SMDHuman/LOTPRobotdog2/README.md

# LOTP Robotdog V2
Opensource Modular Robot dog project. 
[About Project](https://youtu.be/w09KS9C38RI)
