SMDHuman/LOTPRobotdog2/Docs/Parça Listesi 20220502.pdf

06/03/2021

₺9,381.153 | Genel Toplam :
Malzeme | Ünite | Statü | Son Durum | Adet | Fiyat | Kargo | Toplam Maliyet | Alınan Site | Web Adresi
1 | | MPU 9250 9 Eksen Gyro İvme Manyetometre Sensör Modülü | | Satın alındı | Teslim alındı | 1 | 47.25 | 0 | 47.25 | Direnc.net | https://www.direnc.net/mpu-9250-9-eksen-gyro-hizlandirici-manyetometre-sensor-modulu
2 | | VL53L0X Time-of-Flight Regülatörlü Mesafe Sensörü - 200 cm - PL2490 | Lidar modülü | Satın alındı | Teslim alındı | 1 | 86.24 | 0 | 86.24 | Robotistan.com | https://www.robotistan.com/vl6180x-time-of-flight-mesafe-sensoru-1

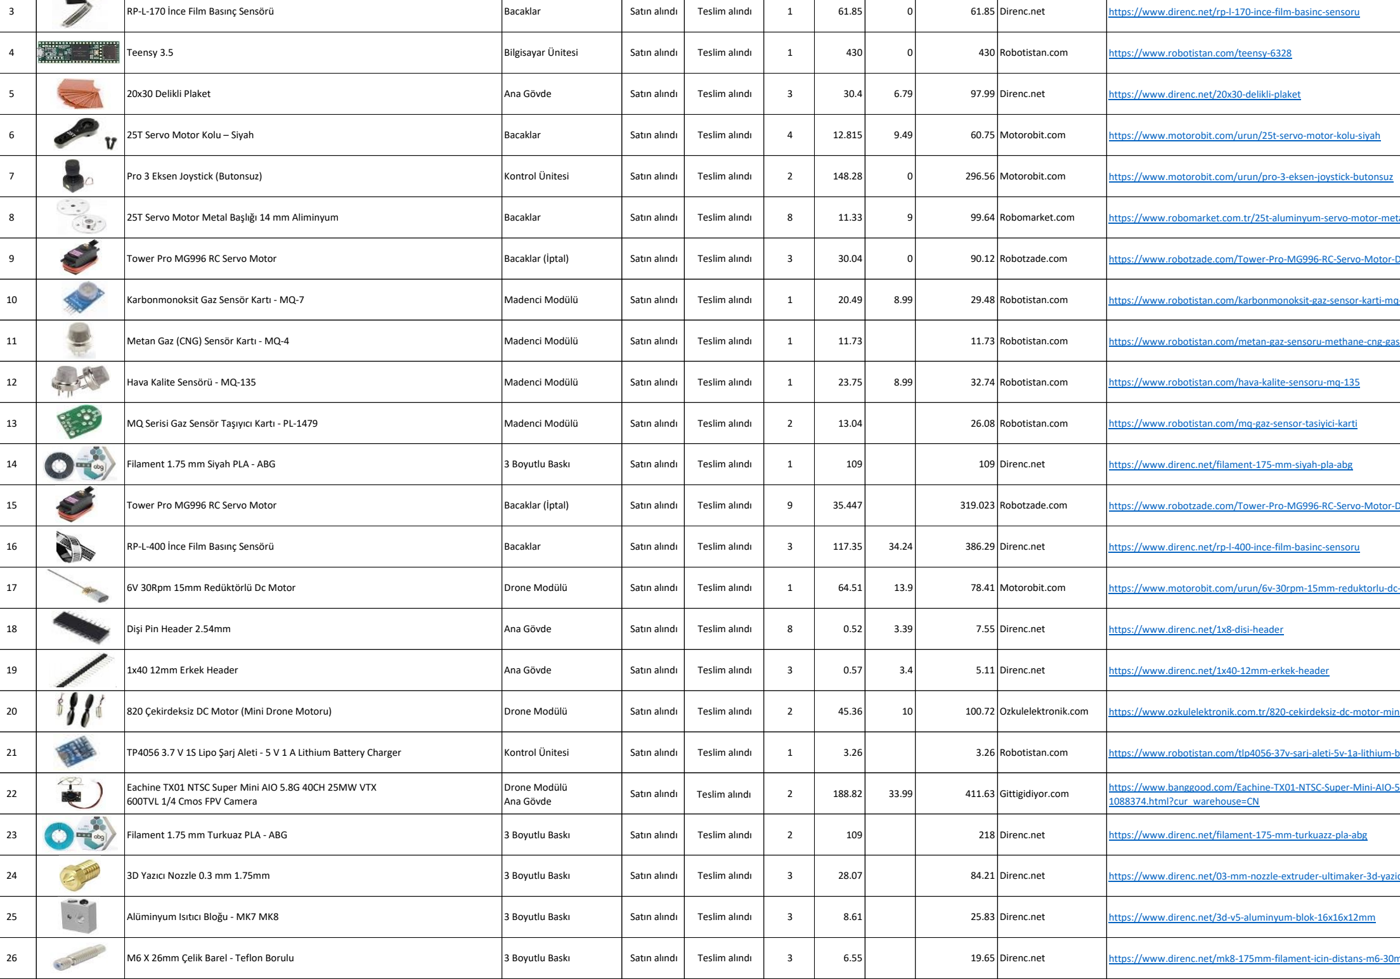
[picture p1: figure]
RP-L-170 İnce Film Basınç Sensörü; Bacaklar; Satın alındı; Teslim alındı; Direnc.net; https://www.direnc.net/rp-l-170-ince-film-basinc-sensoru; Teensy 3.5; Bilgisayar Ünitesi; Robotistan.com; https://www.robotistan.com/teensy-6328; 20x30 Delikli Plaket; Ana Gövde; https://www.direnc.net/20x30-delikli-plaket; Pro 3 Eksen Joystick (Butonsuz); Kontrol Ünitesi; Motorobit.com; https://www.motorobit.com/urun/pro-3-eksen-joystick-butonsuz; Hava Kalite Sensörü - MQ-135; Madenci Modülü; https://www.robotistan.com/hava-kalite-sensoru-mq-135; RP-L-400 İnce Film Basınç Sensörü; https://www.direnc.net/rp-l-400-ince-film-basinc-sensoru; Dişi Pin Header 2.54mm; https://www.direnc.net/1x8-disi-header; 1x40 12mm Erkek Header; https://www.direnc.net/1x40-12mm-erkek-header

6 | | 25T Servo Motor Kolu – Siyah | Bacaklar | Satın alındı | Teslim alındı | 4 | 12.815 | 9.49 | 60.75 | Motorobit.com | https://www.motorobit.com/urun/25t-servo-motor-kolu-siyah
8 | | 25T Servo Motor Metal Başlığı 14 mm Aliminyum | Bacaklar | Satın alındı | Teslim alındı | 8 | 11.33 | 9 | 99.64 | Robomarket.com | https://www.robomarket.com.tr/25t-aluminyum-servo-motor-metal-basligi
9 | | Tower Pro MG996 RC Servo Motor | Bacaklar (İptal) | Satın alındı | Teslim alındı | 3 | 30.04 | 0 | 90.12 | Robotzade.com | https://www.robotzade.com/Tower-Pro-MG996-RC-Servo-Motor-Dijital,PR-1145.html
10 | | Karbonmonoksit Gaz Sensör Kartı - MQ-7 | Madenci Modülü | Satın alındı | Teslim alındı | 1 | 20.49 | 8.99 | 29.48 | Robotistan.com | https://www.robotistan.com/karbonmonoksit-gaz-sensor-karti-mq-7
11 | | Metan Gaz (CNG) Sensör Kartı - MQ-4 | Madenci Modülü | Satın alındı | Teslim alındı | 1 | 11.73 | | 11.73 | Robotistan.com | https://www.robotistan.com/metan-gaz-sensoru-methane-cng-gas-sensor-mq-4
13 | | MQ Serisi Gaz Sensör Taşıyıcı Kartı - PL-1479 | Madenci Modülü | Satın alındı | Teslim alındı | 2 | 13.04 | | 26.08 | Robotistan.com | https://www.robotistan.com/mq-gaz-sensor-tasiyici-karti
14 | | Filament 1.75 mm Siyah PLA - ABG | 3 Boyutlu Baskı | Satın alındı | Teslim alındı | 1 | 109 | | 109 | Direnc.net | https://www.direnc.net/filament-175-mm-siyah-pla-abg
15 | | Tower Pro MG996 RC Servo Motor | Bacaklar (İptal) | Satın alındı | Teslim alındı | 9 | 35.447 | | 319.023 | Robotzade.com | https://www.robotzade.com/Tower-Pro-MG996-RC-Servo-Motor-Dijital,PR-1145.html
17 | | 6V 30Rpm 15mm Redüktörlü Dc Motor | Drone Modülü | Satın alındı | Teslim alındı | 1 | 64.51 | 13.9 | 78.41 | Motorobit.com | https://www.motorobit.com/urun/6v-30rpm-15mm-reduktorlu-dc-motor
20 | | 820 Çekirdeksiz DC Motor (Mini Drone Motoru) | Drone Modülü | Satın alındı | Teslim alındı | 2 | 45.36 | 10 | 100.72 | Ozkulelektronik.com | https://www.ozkulelektronik.com.tr/820-cekirdeksiz-dc-motor-mini-drone-motoru
21 | | TP4056 3.7 V 1S Lipo Şarj Aleti - 5 V 1 A Lithium Battery Charger | Kontrol Ünitesi | Satın alındı | Teslim alındı | 1 | 3.26 | | 3.26 | Robotistan.com | https://www.robotistan.com/tlp4056-37v-sarj-aleti-5v-1a-lithium-battery-charger
22 | | Eachine TX01 NTSC Super Mini AIO 5.8G 40CH 25MW VTX 600TVL 1/4 Cmos FPV Camera | Drone Modülü Ana Gövde | Satın alındı | Teslim alındı | 2 | 188.82 | 33.99 | 411.63 | Gittigidiyor.com | https://www.banggood.com/Eachine-TX01-NTSC-Super-Mini-AIO-5_8G-40CH-25MW-VTX-600TVL-1-or-4-Cmos-FPV-Camera-p-1088374.html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 (https://www.banggood.com/Eachine-TX01-NTSC-Super-Mini-AIO-5_8G-40CH-25MW-VTX-600TVL-1-or-4-Cmos-FPV-Camera-p-1088374.html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)
23 | | Filament 1.75 mm Turkuaz PLA - ABG | 3 Boyutlu Baskı | Satın alındı | Teslim alındı | 2 | 109 | | 218 | Direnc.net | https://www.direnc.net/filament-175-mm-turkuazz-pla-abg
24 | | 3D Yazıcı Nozzle 0.3 mm 1.75mm | 3 Boyutlu Baskı | Satın alındı | Teslim alındı | 3 | 28.07 | | 84.21 | Direnc.net | https://www.direnc.net/03-mm-nozzle-extruder-ultimaker-3d-yazici
25 | | Alüminyum Isıtıcı Bloğu - MK7 MK8 | 3 Boyutlu Baskı | Satın alındı | Teslim alındı | 3 | 8.61 | | 25.83 | Direnc.net | https://www.direnc.net/3d-v5-aluminyum-blok-16x16x12mm
26 | | M6 X 26mm Çelik Barel - Teflon Borulu | 3 Boyutlu Baskı | Satın alındı | Teslim alındı | 3 | 6.55 | | 19.65 | Direnc.net | https://www.direnc.net/mk8-175mm-filament-icin-distans-m6-30mm

# PROJE MALZEME LİSTESİ

₺9,381.153

₺9,381.153

### Satın Alınan :

### Planlanan/İptal :

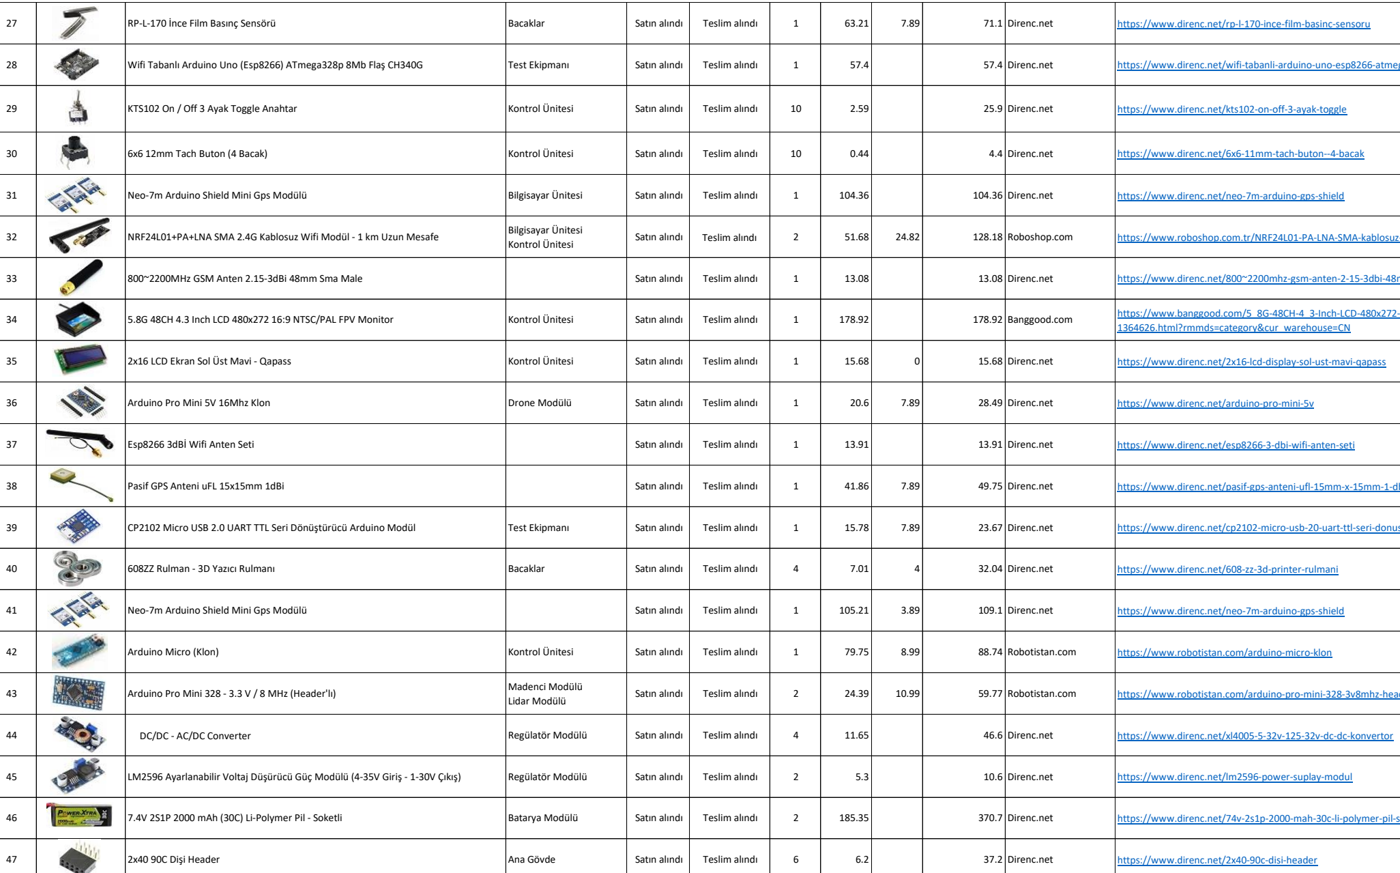
[picture p2: figure]
RP-L-170 İnce Film Basınç Sensörü; Bacaklar; Satın alındı; Teslim alındı; Direnc.net; https://www.direnc.net/rp-l-170-ince-film-basinc-sensoru; Esp8266 3dBİ Wifi Anten Seti; https://www.direnc.net/esp8266-3-dbi-wifi-anten-seti; Arduino Micro (Klon); Kontrol Ünitesi; Robotistan.com; https://www.robotistan.com/arduino-micro-klon; DC/DC - AC/DC Converter; Regülatör Modülü; https://www.direnc.net/xl4005-5-32v-125-32v-dc-dc-konvertor; 2x40 90C Dişi Header; Ana Gövde; https://www.direnc.net/2x40-90c-disi-header

28 | Wifi Tabanlı Arduino Uno (Esp8266) ATmega328p 8Mb Flaş CH340G | Test Ekipmanı | Satın alındı | Teslim alındı | 1 | 57.4 | | 57.4 | Direnc.net | https://www.direnc.net/wifi-tabanli-arduino-uno-esp8266-atmega328p-8mb-flas-ch340g
29 | KTS102 On / Off 3 Ayak Toggle Anahtar | Kontrol Ünitesi | Satın alındı | Teslim alındı | 10 | 2.59 | | 25.9 | Direnc.net | https://www.direnc.net/kts102-on-off-3-ayak-toggle
30 | 6x6 12mm Tach Buton (4 Bacak) | Kontrol Ünitesi | Satın alındı | Teslim alındı | 10 | 0.44 | | 4.4 | Direnc.net | https://www.direnc.net/6x6-11mm-tach-buton--4-bacak
31 | Neo-7m Arduino Shield Mini Gps Modülü | Bilgisayar Ünitesi | Satın alındı | Teslim alındı | 1 | 104.36 | | 104.36 | Direnc.net | https://www.direnc.net/neo-7m-arduino-gps-shield
32 | NRF24L01+PA+LNA SMA 2.4G Kablosuz Wifi Modül - 1 km Uzun Mesafe | Bilgisayar Ünitesi Kontrol Ünitesi | Satın alındı | Teslim alındı | 2 | 51.68 | 24.82 | 128.18 | Roboshop.com | https://www.roboshop.com.tr/NRF24L01-PA-LNA-SMA-kablosuz-wifi-modul-uzun-mesafe
33 | 800~2200MHz GSM Anten 2.15-3dBi 48mm Sma Male | | Satın alındı | Teslim alındı | 1 | 13.08 | | 13.08 | Direnc.net | https://www.direnc.net/800~2200mhz-gsm-anten-2-15-3dbi-48mm-sma-male
34 | 5.8G 48CH 4.3 Inch LCD 480x272 16:9 NTSC/PAL FPV Monitor | Kontrol Ünitesi | Satın alındı | Teslim alındı | 1 | 178.92 | | 178.92 | Banggood.com | https://www.banggood.com/5_8G-48CH-4_3-Inch-LCD-480x272-16-9-NTSC-or-PAL-FPV-Monitor-Auto-Search-With-OSD-Build-in-Battery-p-1364626.html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 (https://www.banggood.com/5_8G-48CH-4_3-Inch-LCD-480x272-16-9-NTSC-or-PAL-FPV-Monitor-Auto-Search-With-OSD-Build-in-Battery-p-1364626.html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)
35 | 2x16 LCD Ekran Sol Üst Mavi - Qapass | Kontrol Ünitesi | Satın alındı | Teslim alındı | 1 | 15.68 | 0 | 15.68 | Direnc.net | https://www.direnc.net/2x16-lcd-display-sol-ust-mavi-qapass
36 | Arduino Pro Mini 5V 16Mhz Klon | Drone Modülü | Satın alındı | Teslim alındı | 1 | 20.6 | 7.89 | 28.49 | Direnc.net | https://www.direnc.net/arduino-pro-mini-5v
38 | Pasif GPS Anteni uFL 15x15mm 1dBi | | Satın alındı | Teslim alındı | 1 | 41.86 | 7.89 | 49.75 | Direnc.net | https://www.direnc.net/pasif-gps-anteni-ufl-15mm-x-15mm-1-dbi-kazanc-adafruit
39 | CP2102 Micro USB 2.0 UART TTL Seri Dönüştürücü Arduino Modül | Test Ekipmanı | Satın alındı | Teslim alındı | 1 | 15.78 | 7.89 | 23.67 | Direnc.net | https://www.direnc.net/cp2102-micro-usb-20-uart-ttl-seri-donusturucu-arduino-modul
40 | 608ZZ Rulman - 3D Yazıcı Rulmanı | Bacaklar | Satın alındı | Teslim alındı | 4 | 7.01 | 4 | 32.04 | Direnc.net | https://www.direnc.net/608-zz-3d-printer-rulmani
41 | Neo-7m Arduino Shield Mini Gps Modülü | | Satın alındı | Teslim alındı | 1 | 105.21 | 3.89 | 109.1 | Direnc.net | https://www.direnc.net/neo-7m-arduino-gps-shield
43 | Arduino Pro Mini 328 - 3.3 V / 8 MHz (Header'lı) | Madenci Modülü Lidar Modülü | Satın alındı | Teslim alındı | 2 | 24.39 | 10.99 | 59.77 | Robotistan.com | https://www.robotistan.com/arduino-pro-mini-328-3v8mhz-headerli
45 | LM2596 Ayarlanabilir Voltaj Düşürücü Güç Modülü (4-35V Giriş - 1-30V Çıkış) | Regülatör Modülü | Satın alındı | Teslim alındı | 2 | 5.3 | | 10.6 | Direnc.net | https://www.direnc.net/lm2596-power-suplay-modul
46 | 7.4V 2S1P 2000 mAh (30C) Li-Polymer Pil - Soketli | Batarya Modülü | Satın alındı | Teslim alındı | 2 | 185.35 | | 370.7 | Direnc.net | https://www.direnc.net/74v-2s1p-2000-mah-30c-li-polymer-pil-soketli
48 | 1x40 90C Dişi Header | Ana Gövde | Satın alındı | Teslim alındı | 6 | 1.24 | | 7.44 | Direnc.net | https://www.direnc.net/1x40-90c-disi-header
49 | 1x40 32mm Erkek Header | Ana Gövde | Satın alındı | Teslim alındı | 15 | 3.36 | 7.89 | 58.29 | Direnc.net | https://www.direnc.net/1x40-32mm-erkek-header
50 | 2.5 V -30V Mini Dijital Kırmızı Voltmetre | Regülatör Modülü | Satın alındı | Teslim alındı | 2 | 15.47 | 7.89 | 38.83 | Direnc.net | https://www.direnc.net/25-v-30-v-mini-dijital-kirmizi-voltmetre
51 | TO126 Silikon İzolatör | | Satın alındı | Teslim alındı | 6 | 0.88 | | 5.28 | Direnc.net | https://www.direnc.net/to126-izalator
52 | XT60 Plug 60A Li-Po Konnektör Takım | Batarya Modülü | Satın alındı | Teslim alındı | 4 | 4.86 | | 19.44 | Direnc.net | https://www.direnc.net/xt60-plug-60a-li-po-konnektor
53 | 3.7V 590 mAh Li-Polymer Pil | Kontrol Ünitesi | Satın alındı | Teslim alındı | 1 | 46.79 | | 46.79 | Direnc.net | https://www.direnc.net/37v-590-mah-li-polymer-pil
54 | 5V Voltaj Yükseltici Regülatörü 0.5/5.5V Giriş | Kontrol Ünitesi | Satın alındı | Teslim alındı | 1 | 46.74 | 8.99 | 55.73 | Robotistan.com | https://www.robotistan.com/5v-yukseltecli-voltaj-regulatoru-ncp1402-5v-boost-regulator-ncp1402-pl
55 | Wireless NRF24L01 2.4 GHz Transceiver Modül - 2.4 GHz Alıcı Verici Modül | Drone Modülü | Satın alındı | Teslim alındı | 1 | 7.67 | 8.99 | 16.66 | Robotistan.com | https://www.robotistan.com/wireless-nrf24l01-24ghz-transceiver-modul-24ghz-alici-verici-modul-1

56 | MPU6050 6 Eksen İvme ve Gyro Sensörü - GY-521 | | Satın alındı | Teslim alındı | 1 | 10.29 | | 10.29 | Robotistan.com | https://www.robotistan.com/mpu6050-6-eksen-ivme-ve-gyro-sensoru-6-dof-3-axis-accelerometer-and-gyros?gclid
57 | Arduino Pro Mini 328 - 3.3 V / 8 MHz (Header'lı) | Madenci Modülü Lidar Modülü | Satın alındı | Teslim alındı | 2 | 24.32 | | 48.64 | Robotistan.com | https://www.robotistan.com/arduino-pro-mini-328-3v8mhz-headerli
58 | 3D Yazıcı Fanı 12V 40x40 mm | 3 Boyutlu Baskı | Satın alındı | Teslim alındı | 1 | 15.19 | 9.5 | 24.69 | Robotzade.com | https://www.robotzade.com/urun/3d-yazici-fani-12v-40x40-mm
59 | Seramik Kablolu 28dB Yüksek Kazançlı Aktif GPS Anteni | Bilgisayar Ünitesi | Satın alındı | Teslim alındı | 1 | 23.09 | 13.9 | 36.99 | Motorobit.com | https://www.motorobit.com/urun/seramik-kablolu-28db-yuksek-kazancli-aktif-gps-anteni
60 | Filament 1.75 mm Siyah PLA - ABG | 3 Boyutlu Baskı | Satın alındı | Teslim alındı | 1 | 133.02 | 9.9 | 142.92 | Direnc.net | https://www.direnc.net/filament-175-mm-siyah-pla-abg
61 | Alüminyum Isıtıcı Bloğu - MK7 MK8 | 3 Boyutlu Baskı | Satın alındı | Teslim alındı | 6 | 8.45 | 9.9 | 60.6 | Direnc.net | https://www.direnc.net/3d-v5-aluminyum-blok-16x16x12mm
62 | M6 X 26mm Çelik Barel - Teflon Borulu | 3 Boyutlu Baskı | Satın alındı | Teslim alındı | 6 | 5.52 | 8.45 | 41.57 | Robitshop.com | https://www.robitshop.com/urun/m6-x-26mm-celik-barel-teflon-borulu
63 | Yarıklı Ağırlık Takımı | Ana Gövde | Satın alındı | Teslim alındı | 2 | 49.98 | 12 | 111.96 | AromelKimya | https://www.aromelkimya.com/urun/yarikli-agirlik-takimi-1
64 | Tower Pro MG996 RC Servo Motor | Bacaklar (İptal) | Satın alındı | Teslim alındı | 3 | 30.58 | 12.5 | 104.24 | Robotzade.com | https://www.robotzade.com/Tower-Pro-MG996-RC-Servo-Motor-Dijital,PR-1145.html
65 | iMax B3 Compact Lipo (2-3S) Şarj Aleti | Batarya Şarj | Satın alındı | Teslim alındı | 1 | 51.41 | 8.45 | 59.86 | Robitshop.com | https://www.robitshop.com/urun/a3-compact-lipo-2-3s-sarj-aleti
66 | MG958 X-Large Digital Servo | Bacaklar | Satın alındı | Teslim alındı | 5 | 65 | 14 | 339 | Pilottr.com | https://www.pilottr.com/urun/towerpro-mg958-servo.html
67 | 5mm Bakır Bant 30mt | Lidar modülü | Satın alındı | Teslim alındı | 1 | 41.21 | | 41.21 | Direnc.net | https://www.direnc.net/5mm-termal-bant-30mt
68 | 7.4 V 2S Lipo Batarya 1350 mAh 25C | Yedek Batarya Modülü | Satın alındı | Teslim alındı | 2 | 130.65 | 18.14 | 279.44 | Robotzade.com | https://www.robotzade.com/urun/7-4-v-2s-lipo-batarya-1350-mah-25c
69 | Tek Damarlı Montaj Kablosu - 22 AWG - 15 Metre Mavi | Genel | Satın alındı | Teslim alındı | 2 | 12.39 | 9.9 | 34.68 | Direnc.net | https://www.direnc.net/22-awg-tek-damarli-montaj-kablosu-15m-mavi
70 | CC3D Uçuş Kontrol kartı | Drone Modülü | Satın alındı | Teslim alındı | 1 | 158.31 | | 158.31 | F1depo.com | https://www.f1depo.com/urun/cc3d-ucus-kontrol-karti
71 | 12V 40W 3D Yazıcı Isıtıcı | 3 Boyutlu Baskı | Satın alındı | Teslim alındı | 2 | 9.54 | | 19.08 | Robotzade.com | https://www.robotzade.com/12V-40W-3D-Yazici-Isitici,PR-1378.html
72 | MG958 X-Large Digital Servo | Bacaklar | Satın alındı | Teslim alındı | 7 | 161.85 | | 1132.95 | Direnc.net | https://www.direnc.net/mg958-metal-disli-servo-motor
73 | M3 6 mm YSB Yıldız Silindirik Baş Metrik Vida - 10 Adet | Genel | Satın alındı | Teslim alındı | 5 | 0.59 | | 2.95 | Robotistan.com | https://www.robotistan.com/m3-6mm-ysb-yildiz-silindirik-bas-metrik-vida-10-adet
74 | M3 8 mm YSB Yıldız Silindirik Baş Metrik Vida - 10 Adet | Genel | Satın alındı | Teslim alındı | 5 | 0.59 | | 2.95 | Robotistan.com | https://www.robotistan.com/m3-8mm-ysb-yildiz-silindirik-bas-metrik-vida-10-adet
75 | M3 Pul - 10 Adet | Genel | Satın alındı | Teslim alındı | 5 | 0.33 | | 1.65 | Robotistan.com | https://www.robotistan.com/m3-pul-50-adet
76 | M3 Somun - 10 Adet | Genel | Satın alındı | Teslim alındı | 10 | 1.14 | | 11.4 | Robotistan.com | https://www.robotistan.com/m3-somun-50-adet
77 | 3.7 V 1S Lipo Batarya-Pil 450 mAh 25C - Mikro Drone Pili | Drone Modülü | Satın alındı | Teslim alındı | 1 | 39.81 | | 39.81 | Robotistan.com | https://www.robotistan.com/37v-lipo-batarya-450mah-25c-mikro-drone-pili
78 | 12V 12mm 60 RPM Redüktörlü Mikro DC Motor | Lidar modülü | Satın alındı | Teslim alındı | 1 | 36.69 | 10.99 | 47.68 | Robotistan.com | https://www.robotistan.com/12v-12mm-60-rpm-reduktorlu-dc-motor
79 | SI2302DS, SI2302, SOT-23 Mosfet Transistör | Genel | Satın alındı | Teslim alındı | 8 | 3.27 | 13.65 | 39.81 | Karakoyelektronik | https://karakoyelektronik.com/transistor/si2302ds-78424
80 | 3x7 Epoxy Çift Taraflı Prototip PCB | Genel | Satın alındı | Teslim alındı | 6 | 3.89 | 9.9 | 33.24 | Direnc.net | https://www.direnc.net/3x7-epoxy-cift-tarafli-prototip-pcb
81 | Arduino FT232 Modül | Lidar modülü | Satın alındı | Teslim alındı | 2 | 23.16 | | 46.32 | Direnc.net | https://www.direnc.net/arduino-ft232-modul
82 | MPU6050 6 Eksen İvme ve Gyro Sensörü gy-521 | Bilgisayar Ünitesi | Satın alındı | Teslim alındı | 3 | 8.2 | 9.94 | 34.54 | F1depo.com | https://www.f1depo.com/MPU6050-6-Eksen-Ivme-ve-Gyro-Sensoru-gy-521,PR-293.html
83 | 100uF 63v Kondansatör | | Satın alındı | Teslim alındı | 20 | 0.93 | | 18.6 | F1depo.com | https://www.f1depo.com/100uF-63v-Kondansator,PR-1538.html
84 | Ams1117 3.3v Voltaj Regülatörü Modülü | Satın alındı | Teslim alındı | 3 | 2.43 | 7.29 | F1depo.com | https://www.f1depo.com/urun/ams1117-3-3v-voltaj-regulatoru-modulu

85 | 1000uF 6.3V Kondansatör 12x8mm | Drone Modülü | Satın alındı | Teslim alındı | 6 | 0.55 | 9.9 | 13.2 | Direnc.net | https://www.direnc.net/1000uf6
86 | 680uF 4V Kondansatör 8.2x7.9mm | Drone Modülü | Satın alındı | Teslim alındı | 6 | 0.41 | | 2.46 | Direnc.net | https://www.direnc.net/680uf4v
87 | Tek Damarlı Montaj Kablosu - 22 AWG - 15 Metre Kırmızı | Genel | Satın alındı | Teslim alındı | 2 | 12.55 | 9.9 | 35 | Direnc.net | https://www.direnc.net/22-awg-tek-damarli-montaj-kablosu-15m-kirmizi

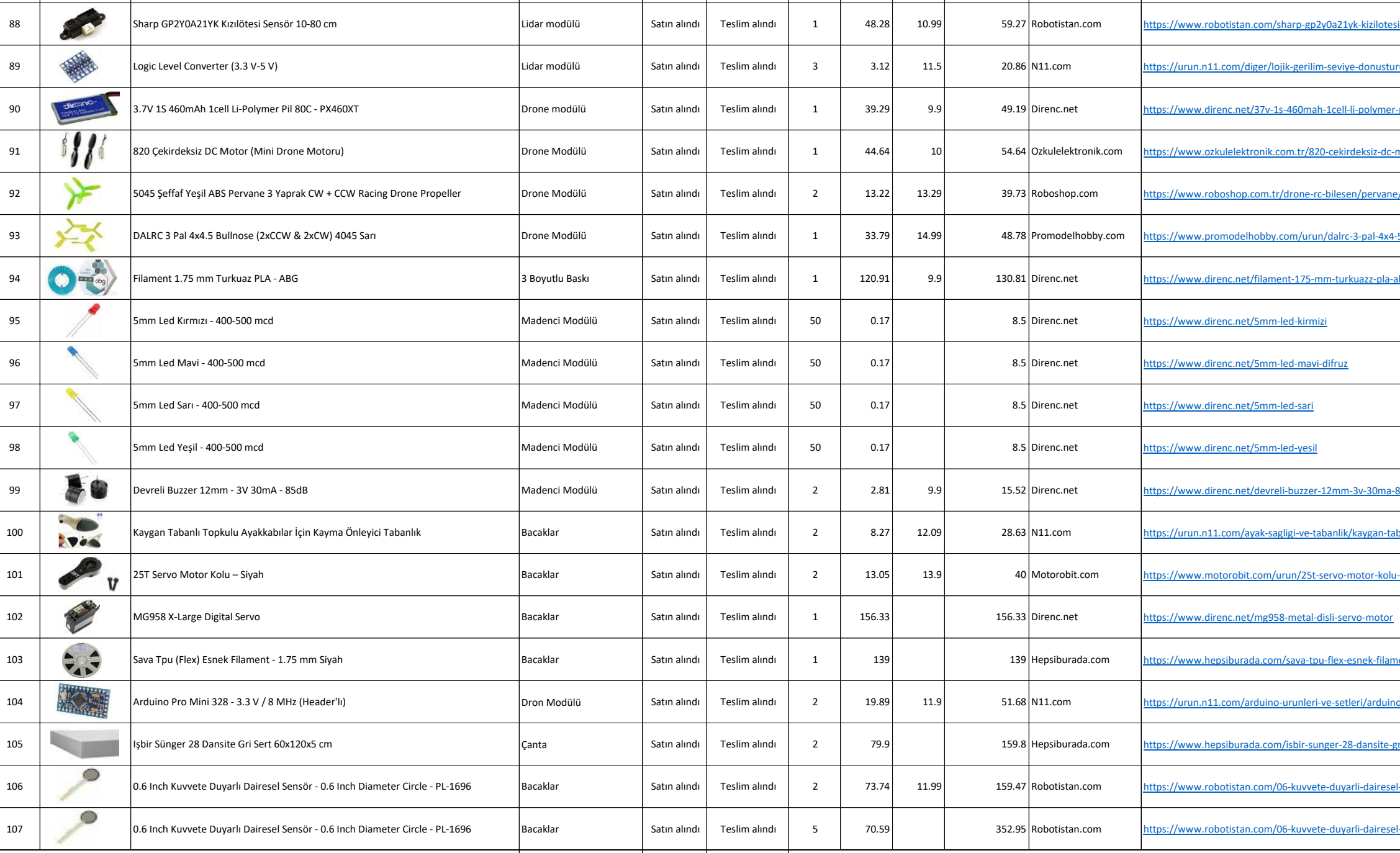
[picture p3: figure]
MG958 X-Large Digital Servo; Bacaklar; Satın alındı; Teslim alındı; Direnc.net; https://www.direnc.net/mg958-metal-disli-servo-motor

88 | Sharp GP2Y0A21YK Kızılötesi Sensör 10-80 cm | Lidar modülü | Satın alındı | Teslim alındı | 1 | 48.28 | 10.99 | 59.27 | Robotistan.com | https://www.robotistan.com/sharp-gp2y0a21yk-kizilotesi-sensor-10-80-cm
89 | Logic Level Converter (3.3 V-5 V) | Lidar modülü | Satın alındı | Teslim alındı | 3 | 3.12 | 11.5 | 20.86 | N11.com | https://urun.n11.com/diger/lojik-gerilim-seviye-donusturucu-33-v-5-v-logic-level-conver-P405026090
90 | 3.7V 1S 460mAh 1cell Li-Polymer Pil 80C - PX460XT | Drone modülü | Satın alındı | Teslim alındı | 1 | 39.29 | 9.9 | 49.19 | Direnc.net | https://www.direnc.net/37v-1s-460mah-1cell-li-polymer-pil-80c-px460xt
91 | 820 Çekirdeksiz DC Motor (Mini Drone Motoru) | Drone Modülü | Satın alındı | Teslim alındı | 1 | 44.64 | 10 | 54.64 | Ozkulelektronik.com | https://www.ozkulelektronik.com.tr/820-cekirdeksiz-dc-motor-mini-drone-motoru
92 | 5045 Şeffaf Yeşil ABS Pervane 3 Yaprak CW + CCW Racing Drone Propeller | Drone Modülü | Satın alındı | Teslim alındı | 2 | 13.22 | 13.29 | 39.73 | Roboshop.com | https://www.roboshop.com.tr/drone-rc-bilesen/pervane/5045-seffaf-yesil-drone-pervanesi
93 | DALRC 3 Pal 4x4.5 Bullnose (2xCCW & 2xCW) 4045 Sarı | Drone Modülü | Satın alındı | Teslim alındı | 1 | 33.79 | 14.99 | 48.78 | Promodelhobby.com | https://www.promodelhobby.com/urun/dalrc-3-pal-4x4-5-bullnose-2xccw-2xcw-4045-sari
94 | Filament 1.75 mm Turkuaz PLA - ABG | 3 Boyutlu Baskı | Satın alındı | Teslim alındı | 1 | 120.91 | 9.9 | 130.81 | Direnc.net | https://www.direnc.net/filament-175-mm-turkuazz-pla-abg
95 | 5mm Led Kırmızı - 400-500 mcd | Madenci Modülü | Satın alındı | Teslim alındı | 50 | 0.17 | | 8.5 | Direnc.net | https://www.direnc.net/5mm-led-kirmizi
96 | 5mm Led Mavi - 400-500 mcd | Madenci Modülü | Satın alındı | Teslim alındı | 50 | 0.17 | | 8.5 | Direnc.net | https://www.direnc.net/5mm-led-mavi-difruz
97 | 5mm Led Sarı - 400-500 mcd | Madenci Modülü | Satın alındı | Teslim alındı | 50 | 0.17 | | 8.5 | Direnc.net | https://www.direnc.net/5mm-led-sari
98 | 5mm Led Yeşil - 400-500 mcd | Madenci Modülü | Satın alındı | Teslim alındı | 50 | 0.17 | | 8.5 | Direnc.net | https://www.direnc.net/5mm-led-yesil
99 | Devreli Buzzer 12mm - 3V 30mA - 85dB | Madenci Modülü | Satın alındı | Teslim alındı | 2 | 2.81 | 9.9 | 15.52 | Direnc.net | https://www.direnc.net/devreli-buzzer-12mm-3v-30ma-85db
100 | Kaygan Tabanlı Topkulu Ayakkabılar İçin Kayma Önleyici Tabanlık | Bacaklar | Satın alındı | Teslim alındı | 2 | 8.27 | 12.09 | 28.63 | N11.com | https://urun.n11.com/ayak-sagligi-ve-tabanlik/kaygan-tabanli-topkulu-ayakkabilar-icin-kayma-onleyici-tabanlik-P250407989
101 | 25T Servo Motor Kolu – Siyah | Bacaklar | Satın alındı | Teslim alındı | 2 | 13.05 | 13.9 | 40 | Motorobit.com | https://www.motorobit.com/urun/25t-servo-motor-kolu-siyah
103 | Sava Tpu (Flex) Esnek Filament - 1.75 mm Siyah | Bacaklar | Satın alındı | Teslim alındı | 1 | 139 | | 139 | Hepsiburada.com | https://www.hepsiburada.com/sava-tpu-flex-esnek-filament-1-75-mm-siyah-p-HBV00000UKF96?magaza=savapol
104 | Arduino Pro Mini 328 - 3.3 V / 8 MHz (Header'lı) | Dron Modülü | Satın alındı | Teslim alındı | 2 | 19.89 | 11.9 | 51.68 | N11.com | https://urun.n11.com/arduino-urunleri-ve-setleri/arduino-pro-mini-328-33-v-8-mhz-headerli-P424323063
105 | Işbir Sünger 28 Dansite Gri Sert 60x120x5 cm | Çanta | Satın alındı | Teslim alındı | 2 | 79.9 | | 159.8 | Hepsiburada.com | https://www.hepsiburada.com/isbir-sunger-28-dansite-gri-sert-60x120x5-cm-p-HBV000011UDIL?magaza=isbironline
106 | 0.6 Inch Kuvvete Duyarlı Dairesel Sensör - 0.6 Inch Diameter Circle - PL-1696 | Bacaklar | Satın alındı | Teslim alındı | 2 | 73.74 | 11.99 | 159.47 | Robotistan.com | https://www.robotistan.com/06-kuvvete-duyarli-dairesel-sensor-force-sensing-resistor-06-circ
107 | 0.6 Inch Kuvvete Duyarlı Dairesel Sensör - 0.6 Inch Diameter Circle - PL-1696 | Bacaklar | Satın alındı | Teslim alındı | 5 | 70.59 | | 352.95 | Robotistan.com | https://www.robotistan.com/06-kuvvete-duyarli-dairesel-sensor-force-sensing-resistor-06-circ
5mm Şeffaf Beyaz Led - 4000-6000 mcd | Kontrol Kumandası | 4
47 | iRangeX Tiny 2.4G 6CH Flysky Receiver | Ana Gövde | Planlanan | 1 | 58.91 | 58.91 | Banggood.com | https://www.banggood.com/IRangX-Tiny-2_4G-6CH-Flysk-Receiver-Compatible-with-Flysky-PPM-Output-for-Eachine-QX80-QX90-QX95-p-1089802.html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 (https://www.banggood.com/IRangX-Tiny-2_4G-6CH-Flysk-Receiver-Compatible-with-Flysky-PPM-Output-for-Eachine-QX80-QX90-QX95-p-1089802.html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)
21 | Tiny SP Racing F3 EVO Uçuş Kontrol Kartı 32bits Naze | Drone Modülü | Planlanan | 1 | 123.07 | 123.07 | F1depo.com | https://www.f1depo.com/urun/tiny-sp-racing-f3-evo-ucus-kontrol-karti-32bits-naze

43 | Arduino CJMCU-530 VL53L0X ToF Mesafe Ölçüm Sensörü Modülü | | Planlanan | | 5 | 78.57 | | 392.85 | Direnc.net | https://www.direnc.net/tof-arduino-mesafe-sensoru-modulu-cjmcu-530-vl53l0x
16 | VL53L0X Time-of-Flight Regülatörlü Mesafe Sensörü - 200 cm - PL2490 | | Planlanan | | 4 | 86.24 | | 344.96 | Robotistan.com | https://www.robotistan.com/vl6180x-time-of-flight-mesafe-sensoru-1
71 | MG958 X-Large Digital Servo | Bacaklar | Satın alındı | İPTAL | 1 | 103.33 | | 103.33 | Trendyol.com | https://www.trendyol.com/tower-pro/mg958-x-large-dijital-servo-p-46575289?boutiqueId=525141&merchantId=132657
91 | 09x4.5 3 Kanatlı Pervane - CW & CCW - Siyah (2 adet) | Drone Modülü | Satın alındı | İADE | 2 | 23.08 | 10.99 | 57.15 | Robotistan.com | https://www.robotistan.com/09x45-3-kanatli-pervane-cw-ccw-siyah
68 | Multirotor Uçuş Kontrol Kartı (Ekransız) | Drone Modülü | Satın alındı | İADE | 1 | 137.35 | | 137.35 | Direnc.net | https://www.direnc.net/multirotor-ucus-kontrol-karti-ekransiz
