SMDHuman/LOTPRobotdog2/Code/Bilgisayar Ünitesi Ana Program 20210120.drawio.png

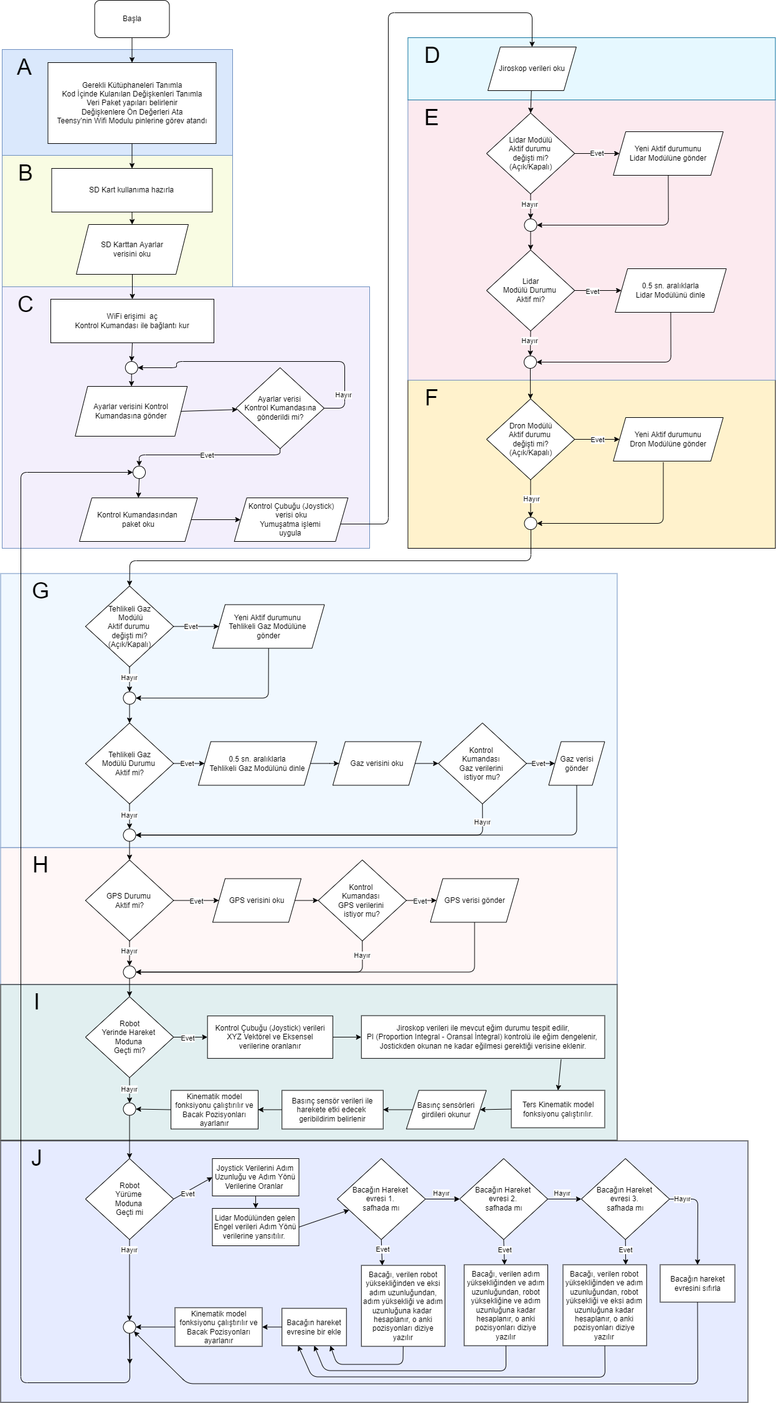
Code/Bilgisayar Ünitesi Ana Program 20210120.drawio.png
