SMDHuman/LOTPRobotdog2/Code/Dron Modülü.drawio.png

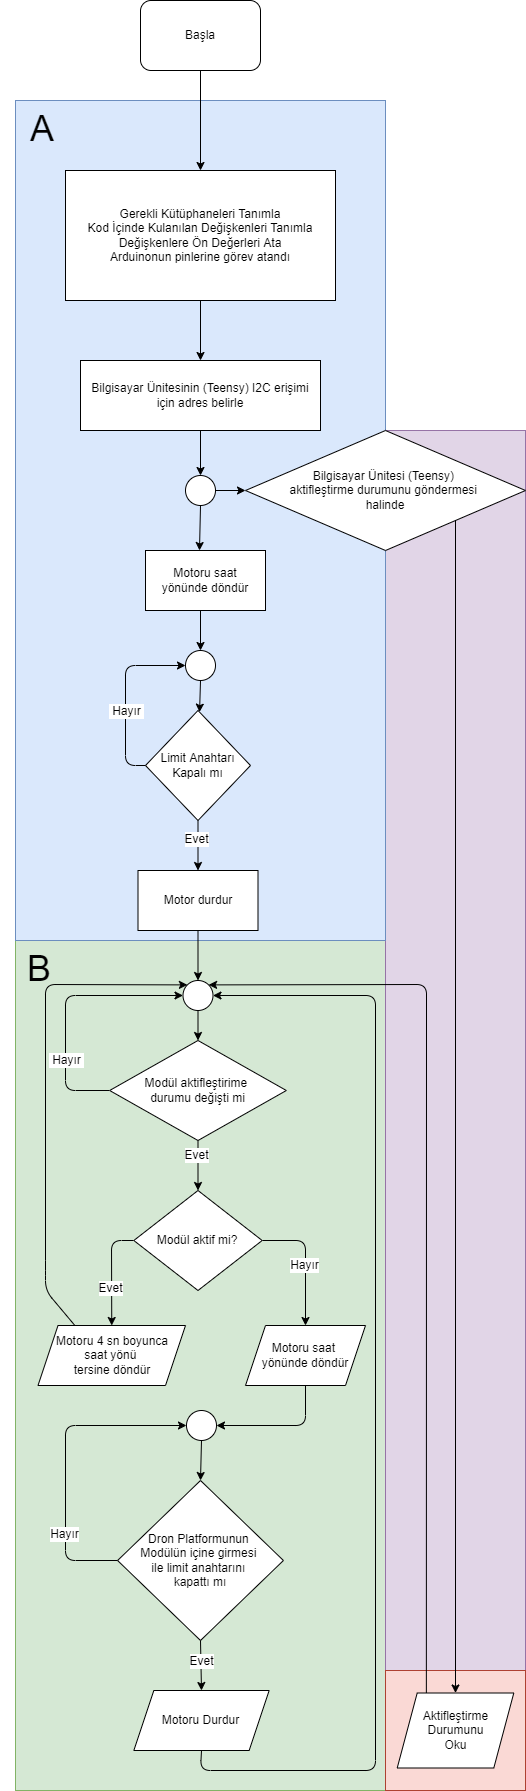
Code/Dron Modülü.drawio.png
