SMDHuman/LOTPRobotdog2/Code/Gas Module.drawio.png

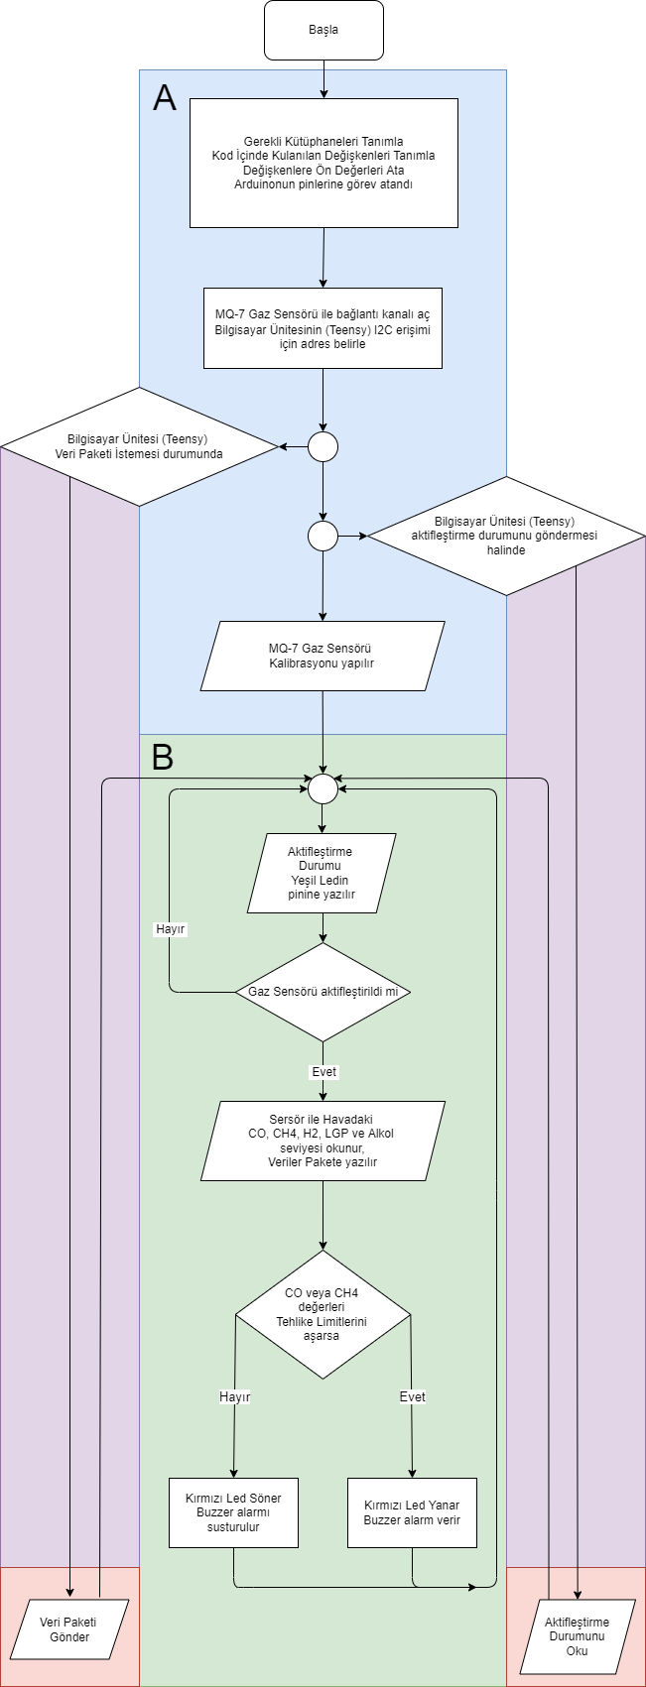
Code/Gas Module.drawio.png
