SMDHuman/LOTPRobotdog2/Code/Kontrol Ünitesi İş Akış Diagramı 20210118.drawio.png

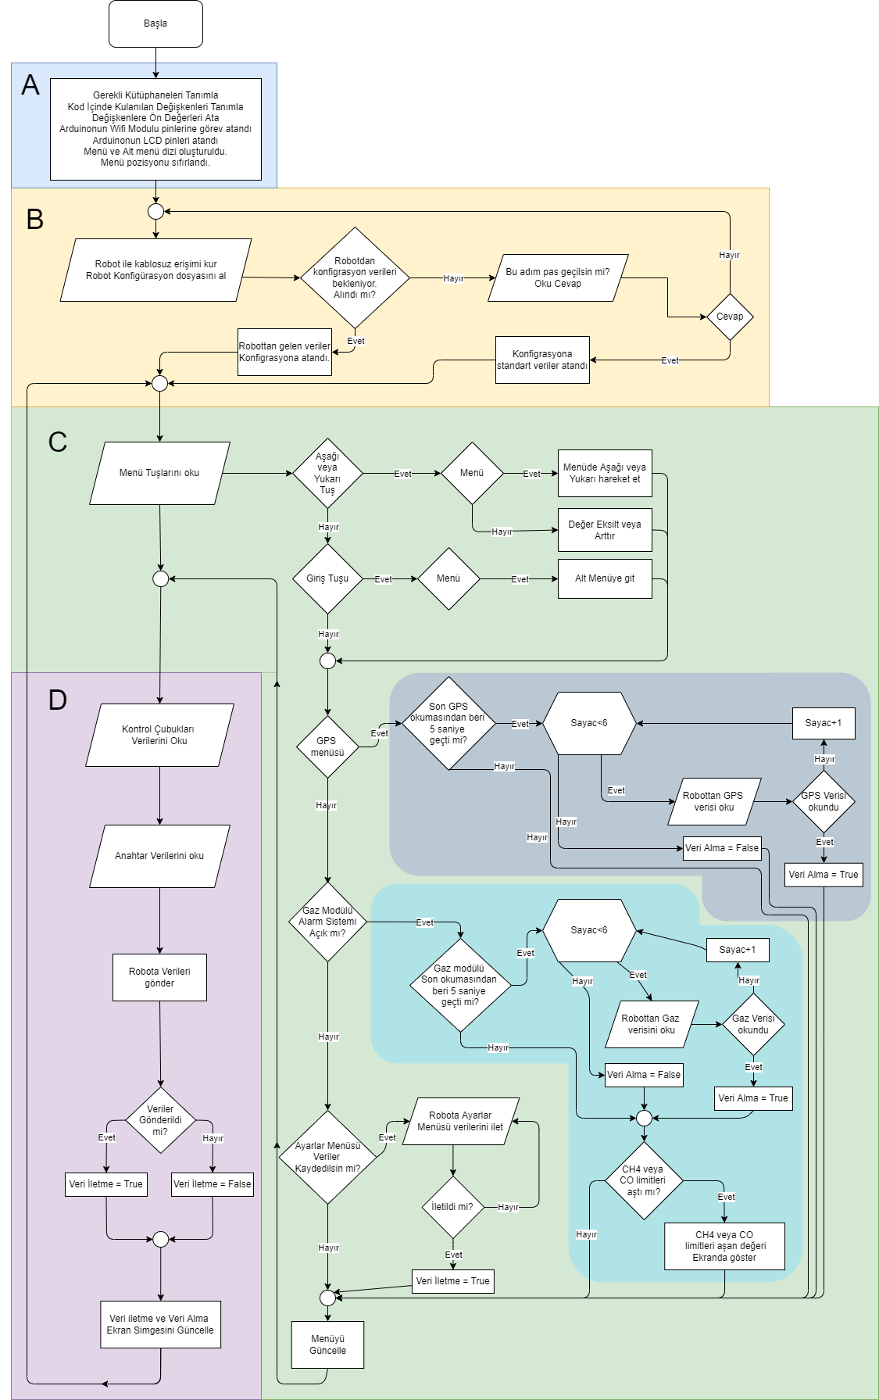
Code/Kontrol Ünitesi İş Akış Diagramı 20210118.drawio.png
