SMDHuman/LOTPRobotdog2/Code/Sabit Hareket.drawio.png

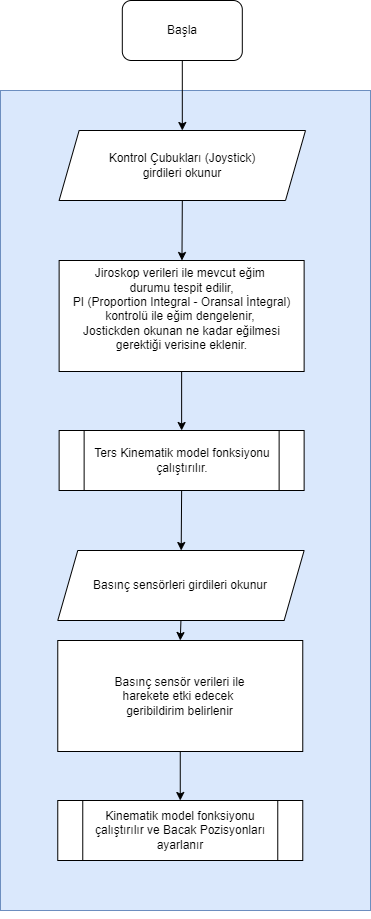
Code/Sabit Hareket.drawio.png
