SMDHuman/LOTPRobotdog2/Robot Step Files/Main Body.stp

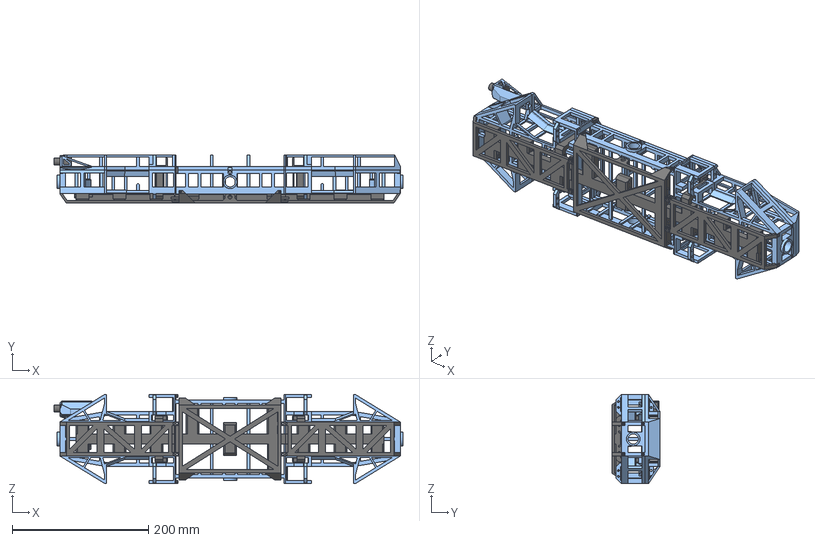
[picture p11: CAD file, 2021-12-10]
Robot Step Files/Main Body.stp
511.4 x 71.0 x 131.0 mm
Buttom Front
Middle Front
Middle Center
Up Center
Up Front
Screw Block x 2
Buttom Center
FPV Camera
Front Bus
Center Bus
Up Rear (1)
Middle Rear (1)
Rear Bus (1)
Buttom Rear (1)
Pin Arranger
