SMDHuman/LOTPRobotdog2/Robot Step Files/Front Left Leg.stp

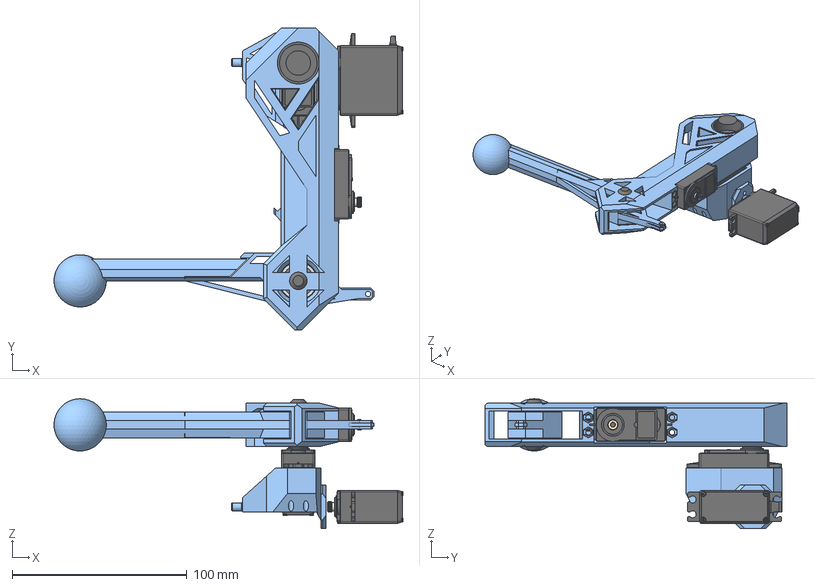
[picture p12: CAD file, 2021-12-10]
Robot Step Files/Front Left Leg.stp
200.0 x 172.9 x 76.9 mm
Servo MG996R x 3
outer race
inner race
retainer
ball x 8
cover x 2
Tibia
Joint Pin
Femur
X Axis Case
Femur Joint Cap
Joint Pin Cap
