SMDHuman/LOTPRobotdog2/Robot Step Files/Drone Module Case.stp

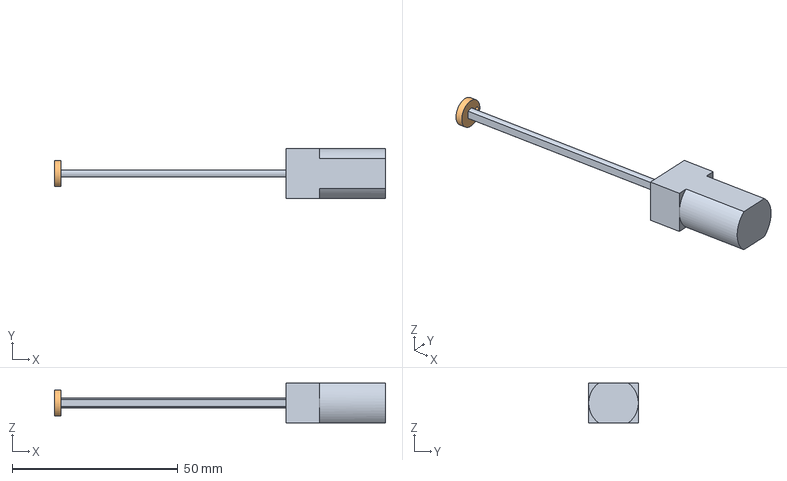
[picture p13: CAD file, 2021-12-10]
Robot Step Files/Drone Module Case.stp
100.0 x 15.0 x 12.0 mm
