SMDHuman/LOTPRobotdog2/Robot Step Files/2 Cube Module.stp

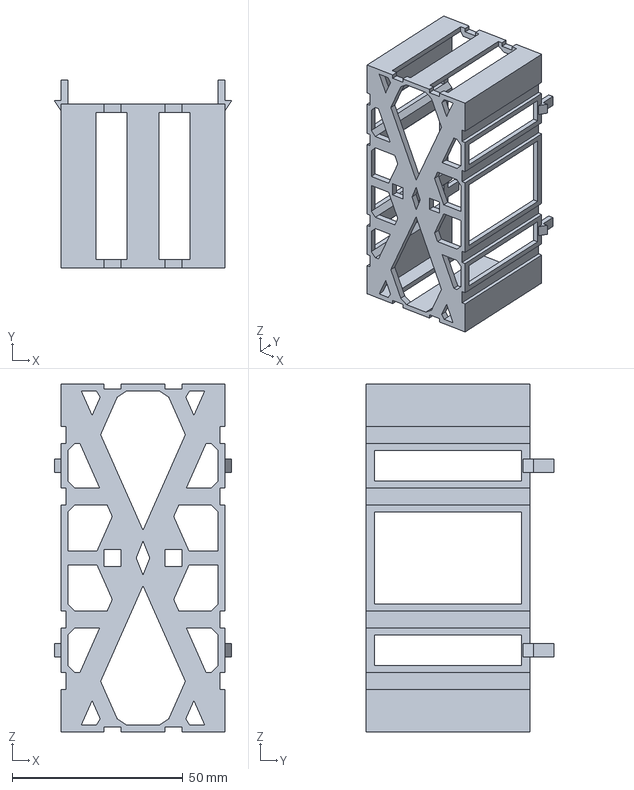
[picture p14: CAD file, 2021-12-10]
Robot Step Files/2 Cube Module.stp
52.0 x 55.0 x 102.0 mm
