SMDHuman/LOTPRobotdog2/Robot Step Files/Gas Module.stp

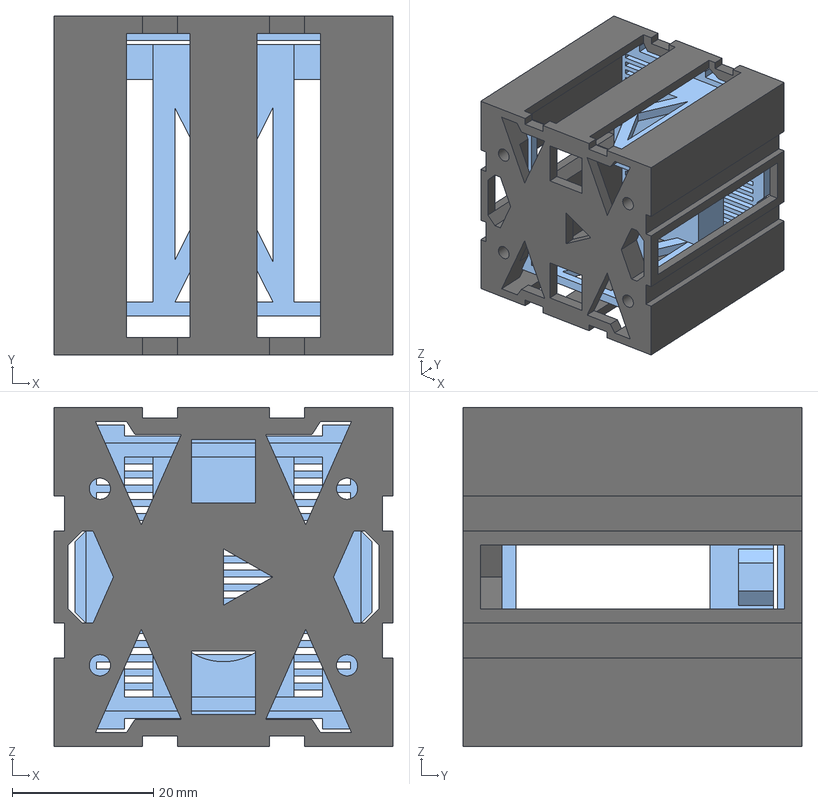
[picture p15: CAD file, 2021-12-10]
Robot Step Files/Gas Module.stp
48.0 x 48.0 x 48.0 mm
