SMDHuman/LOTPRobotdog2/Robot Step Files/Computer Module.stp

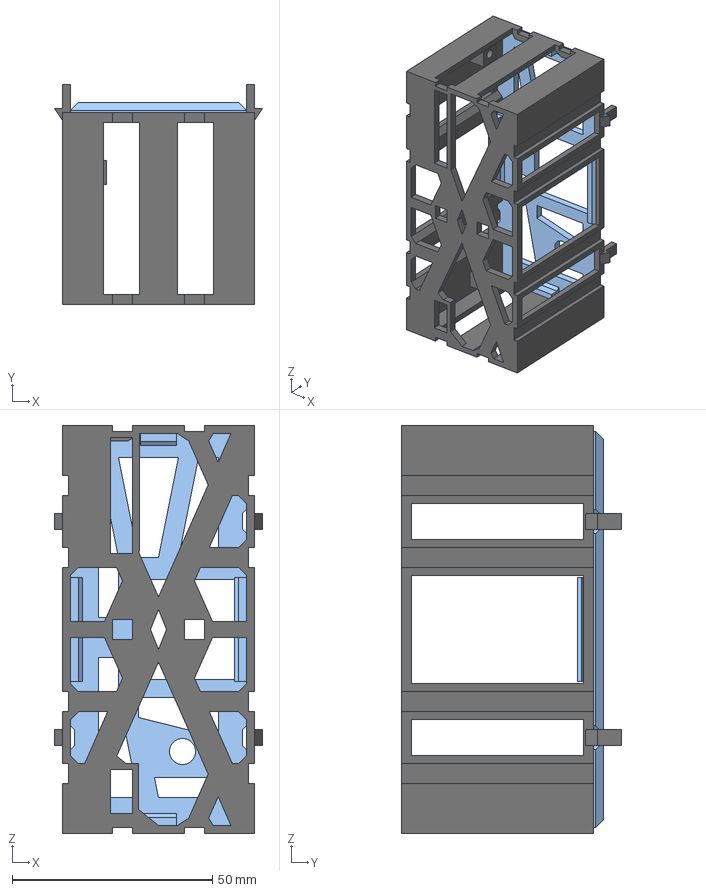
[picture p16: CAD file, 2021-12-10]
Robot Step Files/Computer Module.stp
52.0 x 55.0 x 102.0 mm
