SMDHuman/LOTPRobotdog2/Robot Step Files/1 Cube Module.stp

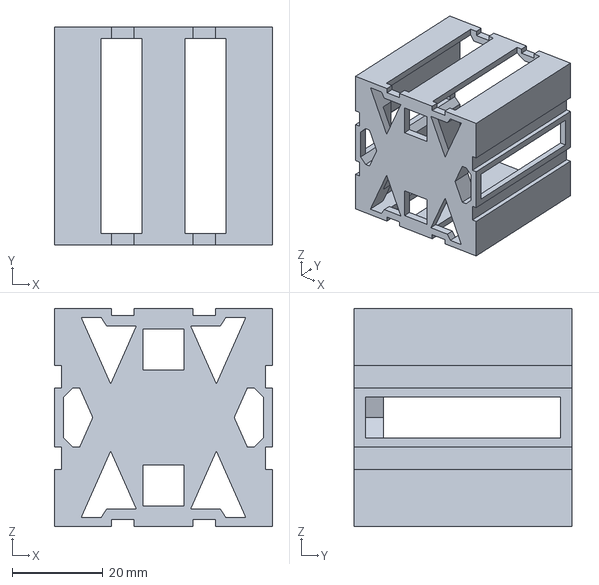
[picture p17: CAD file, 2021-12-10]
Robot Step Files/1 Cube Module.stp
48.0 x 48.0 x 48.0 mm
