SMDHuman/LOTPRobotdog2/Robot Step Files/Lidar Module.stp

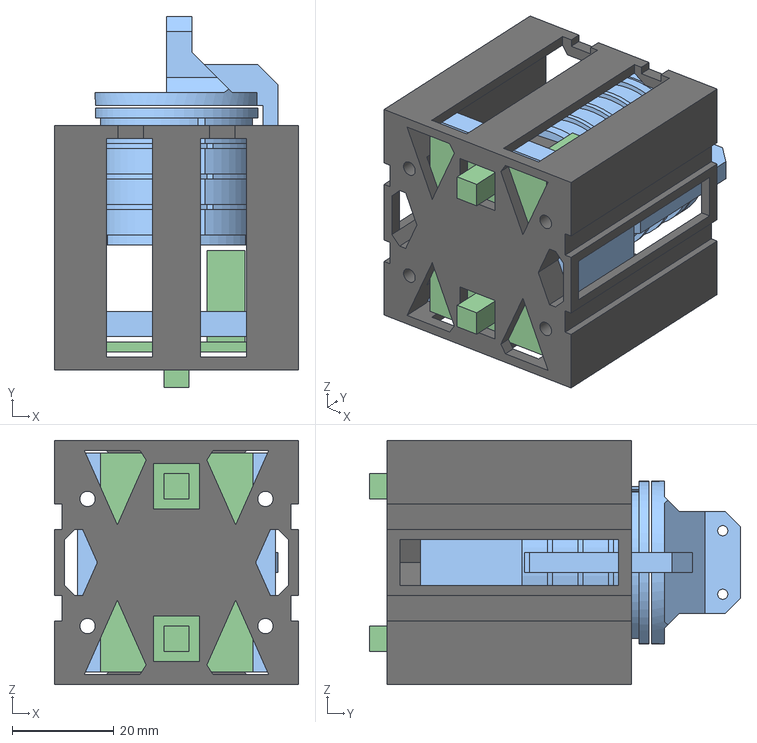
[picture p18: CAD file, 2021-12-10]
Robot Step Files/Lidar Module.stp
48.0 x 73.0 x 48.0 mm
