SMDHuman/LOTPRobotdog2/Robot Step Files/Drone Module.stp

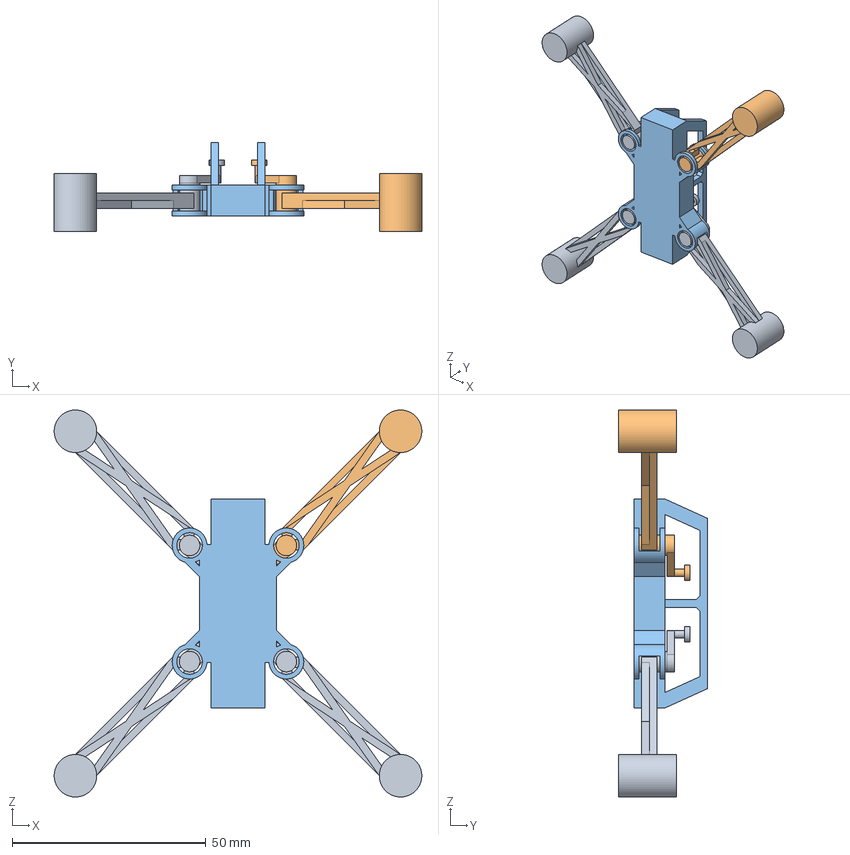
[picture p19: CAD file, 2021-12-10]
Robot Step Files/Drone Module.stp
95.0 x 23.0 x 100.0 mm
FR Arm
FL Arm
RR Arm
RL Arm (1)
Drone Body
