SMDHuman/LOTPRobotdog2/Robot Step Files/Regulator Module.stp

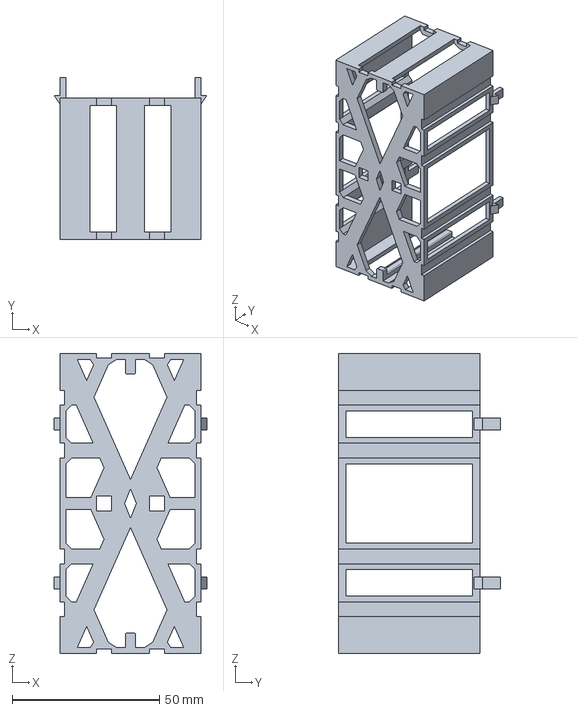
[picture p20: CAD file, 2021-12-10]
Robot Step Files/Regulator Module.stp
52.0 x 55.0 x 102.0 mm
