SMDHuman/LOTPRobotdog2/Robot Step Files/Battary Module.stp

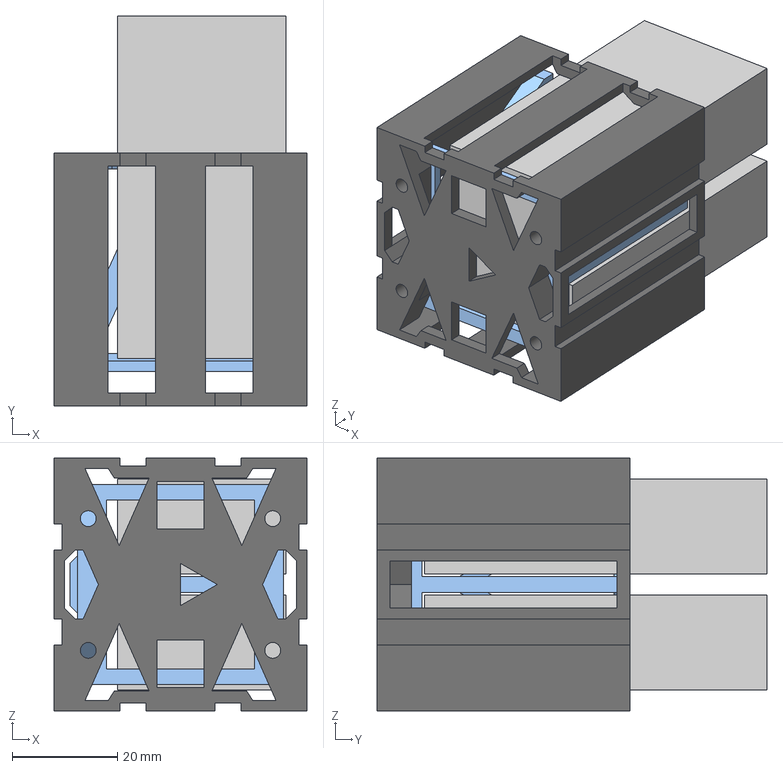
[picture p21: CAD file, 2021-12-10]
Robot Step Files/Battary Module.stp
48.0 x 74.0 x 48.0 mm
