SMDHuman/LOTPRobotdog2/(list of files, drawings)

Other design files:
Electronics/Computer Block.fzz
Electronics/Controller.fzz
Electronics/Drone Case1.fzz
Electronics/Drone Case.fzz
Electronics/Lidar.fzz
Electronics/LOTP_Gas_Module.fzz
Electronics/Main Distrubute Board.fzz
Electronics/Regulator Mobule.fzz
